SystemsCyber/Brake-Force-Tester/Data/images/new_gauge.png

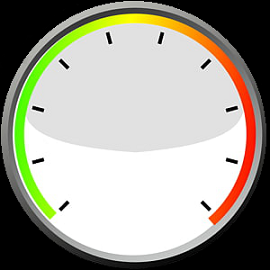
Data/images/new_gauge.png
