SystemsCyber/Brake-Force-Tester/README.md

# Brake-Force-Tester
+# Brake_Chamber_Test  The codes are for the Brake test bed project developed by Dr.Jeremy Daily. This reposisitory contains code used for Raspberry pi 4.0 and Teensy 3.0.

Teensy working code has the sensors updated and will be working with the condition now.
