SystemsCyber/Brake-Force-Tester/hardware/Internal Circuit Board/Bill of Materials  (version 1).xlsx

Index | Quantity | Reference Designator | Manufacturer | Manufacturer Part Number | Supplier | Supplier Part Number | Link to Datasheet | Description | Unit Price (USD) | Extended Price (USD)
1 | 2 |  | Hammond Manufacturing | RZ0232C | Digikey | 164-RZ0232C-ND | https://www.hammfg.com/electronics/small-case/plastic/rz.pdf | BOX POLY IP65 LTGRY 8.7X5.8X2.95 | 21.95 | 43.9
2 | 2 | D1 | onsemi | 1N5820G | Digikey | 1N5820GOS-ND | https://www.onsemi.com/pdf/datasheet/1n5820-d.pdf | Diode Schottky 20 V 3A Through Hole Axial | 0.61 | 1.22
3 | 2 | J1 | Delta Electronics | S24SE05003NDFA | Digikey | 941-1580-ND | https://filecenter.deltaww.com/products/download/01/0102/datasheet/DS_S24SE_S24DE_30W.pdf | Isolated Module DC DC Converter 1 Output 5V - - 3A 9V - 36V Input | 18.57 | 37.14
4 | 2 | T2 | Traco Power | TSRN 1-2450 | Digikey | 1951-2614-ND | https://www.tracopower.com/products/tsrn1.pdf | Linear Regulator Replacement DC DC Converter 1 Output 5V 1A 6.5V - 36V Input | 11.32 | 22.64
5 | 2 | C1 | Rubycon | 25ZL330MEFC8X16 | Digikey | 1189-3769-1-ND | https://www.rubycon.co.jp/wp-content/uploads/catalog-aluminum/YXF.pdf | 330 µF 25 V Aluminum Electrolytic Capacitors Radial, Can 3000 Hrs @ 105°C | 0.235 | 0.47
6 | 2 | L1 | Murata Electronics | LQM21NN1R0K10D | Digikey | 490-1117-2-ND | https://search.murata.co.jp/Ceramy/image/img/P02/JELF243B-0005.pdf | FIXED IND 1UH 50MA 400 MOHM SMD | 0.23 | 0.46
7 | 2 | C2 | KEMET | ESK106M016AC3KA | Digikey | 399-ESK106M016AC3KATR-ND | https://content.kemet.com/datasheets/KEM_A4004_ESK.pdf | CAP ALUM 10UF 20% 16V RADIAL | 0.24 | 0.48
8 | 10 | R14,R16,R18,R20 | Xicon | 293-1K-RC | Digikey | 2197-294-120-RC-ND | https://s3.amazonaws.com/tubedepot-com-production/spree/attached_files/resistor293-294.pdf?1388436058 | RES 1KOHM 5% 1/2W AXIAL | 0.15 | 1.5
9 | 10 | R15,R17,R19,R21 | Xicon | 294-2.2K-RC | Digikey | 2197-293-1K-RC-ND | https://s3.amazonaws.com/tubedepot-com-production/spree/attached_files/resistor293-294.pdf?1388436058 | RES 2.2K OHM 5% 1/2W AXIAL | 0.1 | 1
10 | 10 | R1,R2 | Xicon | 294-4.7K-RC | Digikey | 2197-294-4.7K-RC-ND | https://s3.amazonaws.com/tubedepot-com-production/spree/attached_files/resistor293-294.pdf?1388436058 | RES 4.7K OHM 5% 1W AXIAL | 0.15 | 1.5
11 | 2 | C3 | Nichicon | UMT1H0R1MDD1TP | Digikey | 493-10288-1-ND | https://www.nichicon.co.jp/english/products/pdfs/e-umt.pdf | CAP ALUM 0.1UF 20% 50V RADIAL | 0.061 | 0.122
12 | 15 | R3-R8 | YAGEO | CFR25SJT-52-10K | Digikey | 13-CFR25SJT-52-10KCT-ND | https://www.yageo.com/upload/media/product/productsearch/datasheet/lr/YAGEO%20CFR_datasheet_2021v0.pdf | RES 10K OHM 5% 1/4W AXIAL | 0.1 | 1.5
13 | 10 | R9-R13 | YAGEO | CFR-25JB-52-470R | Digikey | 470QBK-ND | https://www.yageo.com/upload/media/product/productsearch/datasheet/lr/YAGEO%20CFR_datasheet_2021v0.pdf | RES 470 OHM 5% 1/4W AXIAL | 0.1 | 1
14 | 5 | D2 | Rohm Semiconductor | SLR-342MCT32 | Digikey | 846-SLR-342MCT32CT-ND | https://media.digikey.com/pdf/Data%20Sheets/Rohm%20PDFs/SLR-342_RevA.pdf | Green 572nm LED Indication - Discrete 2.1V Radial | 0.54 | 2.7
15 | 5 | D3 | CreeLED, Inc. | C503B-BCS-CV0Z0461 | Digikey | C503B-BCS-CV0Z0461-ND | https://media.digikey.com/pdf/Data%20Sheets/CREE%20Power/C503B-BCS_BCN_GCS_GCN_2019.pdf | Blue 470nm LED Indication - Discrete 3.2V Radial | 0.21 | 1.05
16 | 5 | D4 | Lite-On Inc. | LTL-4273 | Digikey | 160-1966-ND | https://media.digikey.com/pdf/Data%20Sheets/Lite-On%20PDFs/LTL-4273.pdf | Amber 588nm LED Indication - Discrete 2.1V Radial | 0.36 | 1.8
17 | 5 | D5 | Kingbright | WP7113YD | Digikey | 754-1284-ND | https://www.kingbrightusa.com/images/catalog/SPEC/WP7113YD.pdf | Yellow 588nm LED Indication - Discrete 2.1V Radial | 0.37 | 1.85
18 | 5 | D6 | CreeLED, Inc. | C503C-WAN-CBBDB152 | Digikey | C503C-WAN-CBBDB152CT-ND | https://cree-led.com/media/documents/C503C-WAS-WAN-1098.pdf | White, Cool 9000K LED Indication - Discrete 3.2V Radial | 0.24 | 1.2
19 | 2 | J2 | Molex | 39301020 | Digikey | WM1351-ND | https://www.molex.com/pdm_docs/ps/PS-5556-001.pdf | Connector Header Through Hole, Right Angle 2 position | 0.72 | 1.44
20 | 2 | J4 | Molex | 39012040 | Digikey | WM3701-ND | https://www.molex.com/pdm_docs/sd/039012040_sd.pdf | 4 Rectangular Connectors - Housings Receptacle Natural 0.165" (4.20mm) | 0.39 | 0.78
21 | 2 | J8 | Molex | 353180820 | Digikey | WM13197-ND | https://www.molex.com/pdm_docs/sd/353180820_sd.pdf | Connector Header Through Hole, Right Angle 8 position 0.165" (4.20mm) | 0.77 | 1.54
22 | 2 | J22 | Molex | 39295223 | Digikey | WM3930-ND | https://www.molex.com/pdm_docs/sd/039295223_sd.pdf | Connector Header Through Hole, Right Angle 22 position 0.165" (4.20mm) | 9.13 | 18.26
23 | 2 | U3 | Microchip Technology | ATECC608A-MAHCZ-T | Digikey | ATECC608A-MAHCZ-TTR-ND | https://ww1.microchip.com/downloads/en/DeviceDoc/ATECC608A-CryptoAuthentication-Device-Summary-Data-Sheet-DS40001977B.pdf | Authentication Chip 8-UDFN (2x3) | 1.03 | 2.06
 |  |  |  | ST14DD00 |  | EG4814-ND |  | SWITCH TOGGLE SPDT 20A MOTOR DIRECTION CONTROL
 |  |  |  | 39013026 |  | WM12736-ND |  | CONN PLUG HSG 2POS MINIFIT CONNECTORS FOR POWER
 |  |  |  | 39039022 |  | WM19546-ND |  | CONN RCPT HSG 2POS MINIFIT CONNECTORS FOR POWER
 |  |  |  | 1586000-2 |  | A30654-ND
 |  |  |  | 469990290 |  | WM23325-ND
 |  |  |  | 50291662 |  | WM14874-ND
 |  |  |  | S24SE05003NDFA |  | 941-1580-ND
 |  |  |  | 469990276 |  | WM23324-ND
 |  |  |  | 39039042 |  | WM13116-ND
 |  |  |  | 794954-2 |  | A30590-ND
 |  |  |  | 39014030 |  | WM18434-ND
 |  |  |  | 39014032 |  | WM18437-ND
