SystemsCyber/Brake-Force-Tester/hardware/Internal Circuit Board/Brake_SCH.pdf

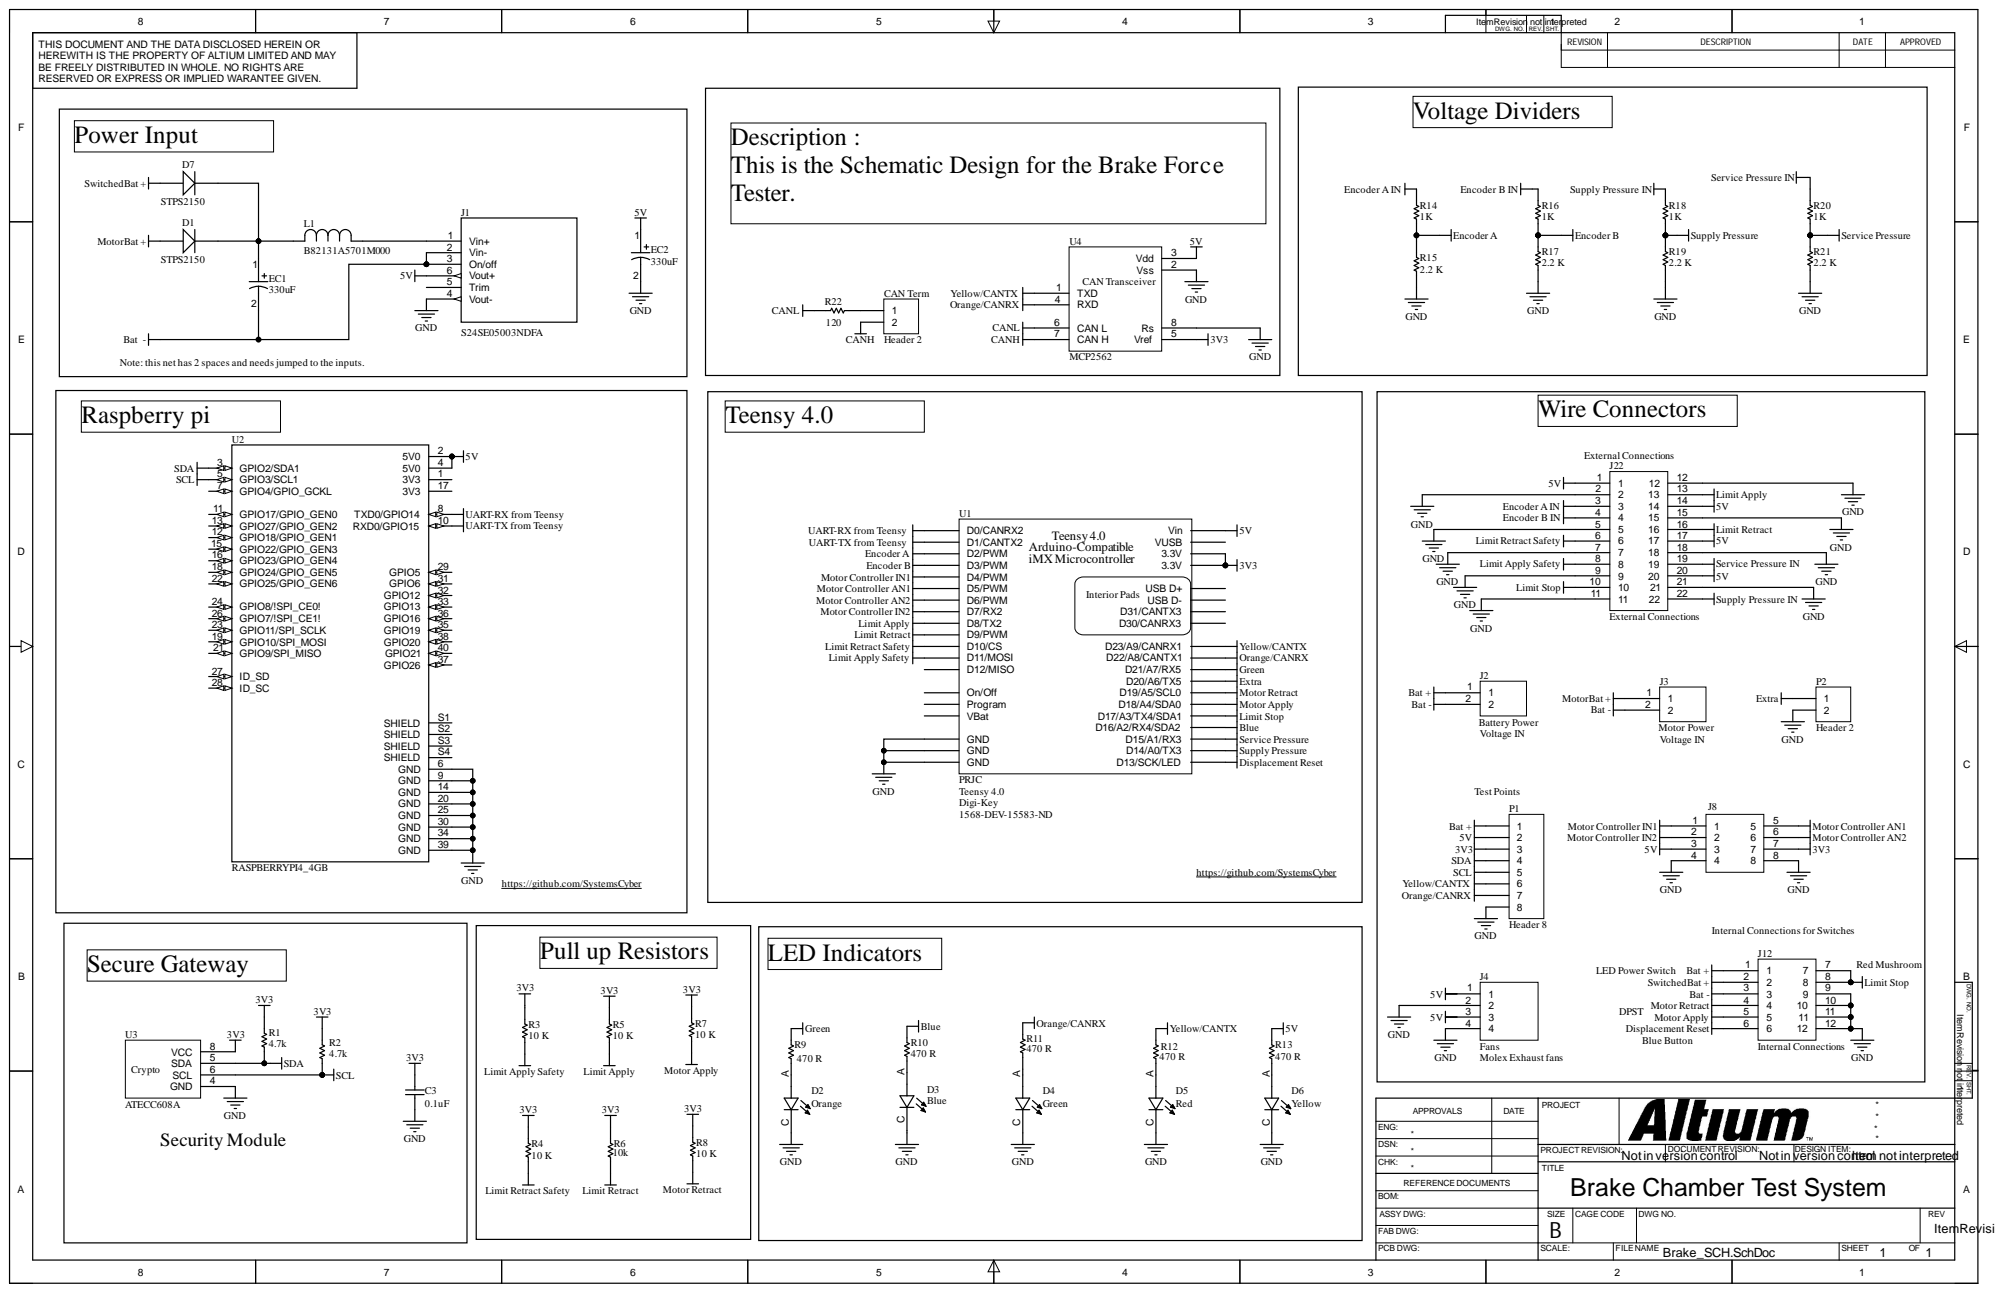
[picture p2: page 1]

8 | 7 | 6 | 5 | 4 | 3 | ItemRevision not in1terpreted | DWG. NO. | REV. | SHT. | 2 | 1

THIS DOCUMENT AND THE DATA DISCLOSED HEREIN OR HEREWITH IS THE PROPERTY OF ALTIUM LIMITED AND MAY BE FREELY DISTRIBUTED IN WHOLE. NO RIGHTS ARE RESERVED OR EXPRESS OR IMPLIED WARANTEE GIVEN. | | REVISION | DESCRIPTION | DATE | APPROVED

Description :
This is the Schematic Design for the Brake Force
Tester.

Note: this net has 2 spaces and needs jumped to the inputs.

UART-RX from Teensy
UART-TX from Teensy

https://github.com/SystemsCyber

Internal Connections for Switches

REV. SHT. DWG. NO.

Yellow/CANTX Orange/CANRX

Brake Chamber Test System
