SystemsCyber/Brake-Force-Tester/(list of files, drawings)

Other design files:
hardware/Internal Circuit Board/Brake_PCB.PcbDoc
hardware/Internal Circuit Board/Brake_PCB_v2.PcbDoc
hardware/Internal Circuit Board/Brake_SCH.SchDoc
