SystemsCyber/Brake-Force-Tester/hardware/Internal Circuit Board/Wiring Colours.docx

Orange -AN1

White with Black stripes -AN2

Brown -IN1

White -IN2

Signal | Teensy Pin | Color | J8 PORT | Resistors
AN1 | 5 | Orange | 5 | 10K to ground
AN2 | 6 | White with Black Stripes | 6 | 10K to ground
IN1 | 4 | Brown | 1 | 10K to ground
IN2 | 7 | White | 2 | 10K to ground

USB C power supply is connected to 5V power adapter.

4
