SystemsCyber/Brake-Force-Tester/Data/brake_force_test_data_2023-08-13 13_02_16.216295.csv

Brake Force Tester
Version | 1
Version Date | 2023-08-17
Date of Test | 2023-08-13 13:02:16.216295
run_time | Direction | ActuatorVelocity | Displacement | SwitchApply_Value | SwitchApply_Value | SwitchRetract_Value | SerialApply_Value | SerialRetract_Value | ServicePressure_bytes | ServicePressure_Value | SupplyPressure_bytes | SafetyApply_Value | LimitRetract_Value | LimitApply_Value | Timeout_Value | EmergencyStop | millipounds
milliseconds | label | percent | mm | 0=pressed | 0=pressed | 0=pressed | 1=Apply Motor | 1=Retract Motor | analogRead | PSI | AnalogRead | PSI | LimitRetract_Value | 0=pressed | 0=No Comms | 0=pressed | millipounds
702554 | Apply | +5 | -0.126 | 1 | 1 | 0 | 0 | 497 | 107.30 | 648 | 107.50 | 1 | 1 | 1 | 1 | 1 | 1 | 0 | -2068.870
702654 | Apply | +5 | -0.126 | 1 | 1 | 0 | 0 | 498 | 107.60 | 651 | 108.10 | 1 | 1 | 1 | 1 | 1 | 1 | 0 | -2068.870
702754 | Apply | +5 | -0.126 | 1 | 1 | 0 | 0 | 497 | 107.30 | 649 | 107.70 | 1 | 1 | 1 | 1 | 1 | 1 | 0 | -2068.830
702854 | Apply | +5 | -0.126 | 1 | 1 | 0 | 0 | 496 | 107.00 | 648 | 107.50 | 1 | 1 | 1 | 1 | 1 | 1 | 0 | -2068.830
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
