SystemsCyber/Brake-Force-Tester/hardware/Internal Circuit Board/PCB Errata.pptx

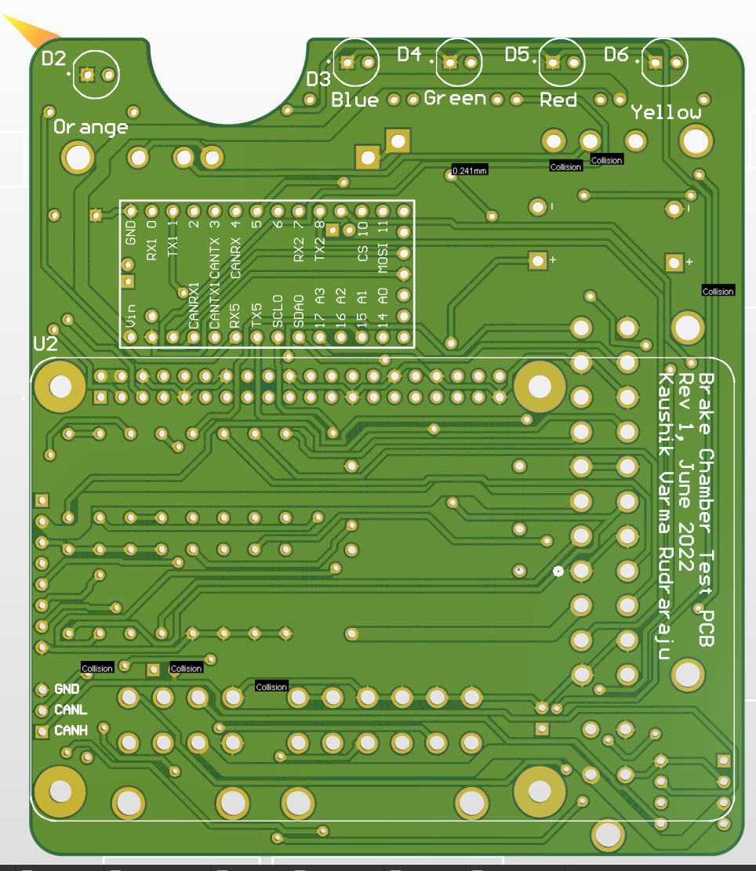
[picture p3: figure]

39 29 19 9 1

Note:
The TXD line will have to tie to the Raspberry Pi header instead of the PCB header. All other connections can be made with wire on the PCB.

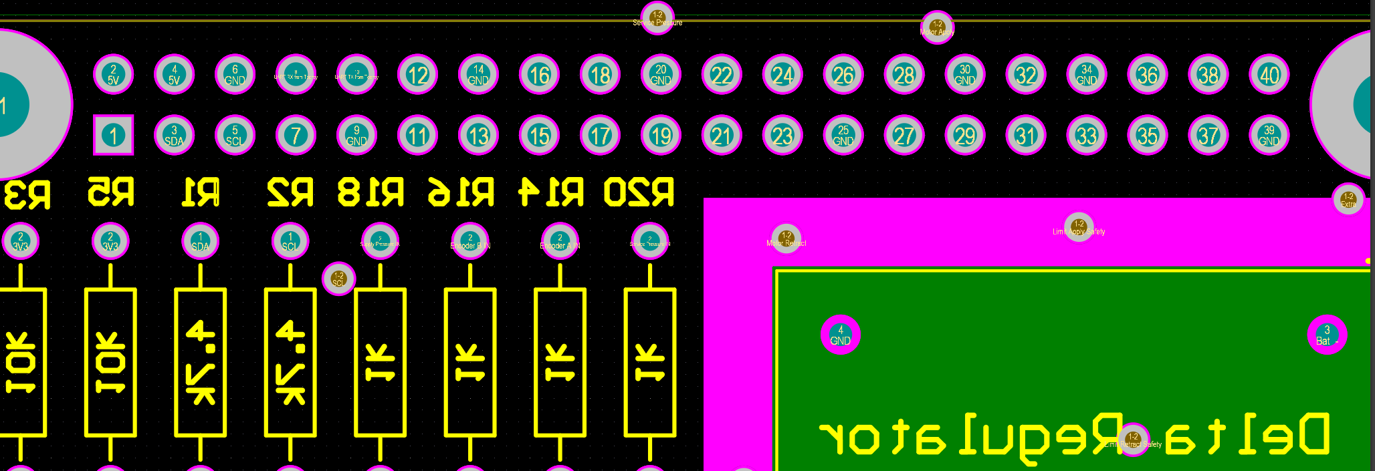
[picture p4: figure]

= Remove Pin from PCB

RXD

GND

TXD

5V

SDA

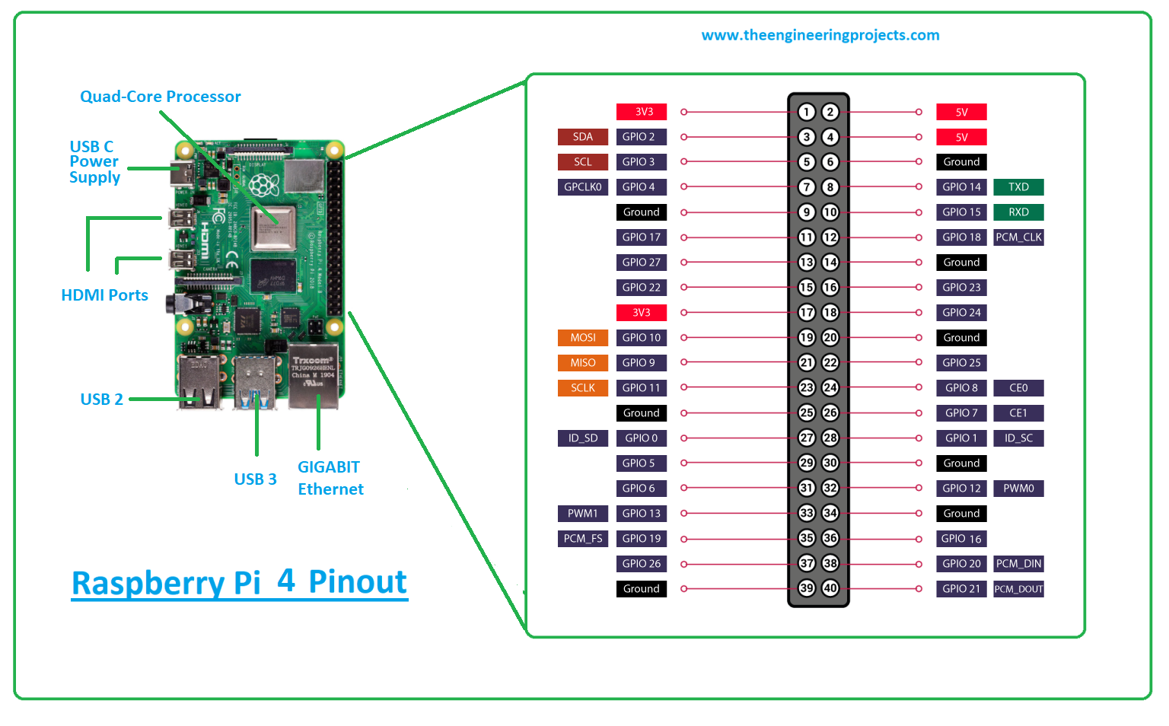
[picture p5: figure]

SCL
