SystemsCyber/Brake-Force-Tester/(commit log)

2023-01-21 Added Hardware Docs
    [Bill of Materials (version 1).xlsx, Brake_PCB.PcbDoc, Brake_PCB_v2.PcbDoc, Brake_SCH.SchDoc]
2023-08-13 Clean directory
    [2log.csv]
2023-08-13 Added Library and initial Teensy Code
2023-08-13 Working Teensy Code
2023-08-13 Create brake_force_test_data_2023-08-13 13_02_16.216295.csv
    Results that we took today
    [brake_force_test_data_2023-08-13 13_02_16.216295.csv]
